ArayCHN/Smart_cart/(threads)

Thread 1 (2018-05-02):

Velocity calc by time interval error from time to time

ArayCHN, 2018-05-02:
一个奇怪的问题：在一些时候，当速度为0好久，然后启动一下，一瞬间速度会很小，紧接着接下来就会出现一个很大的速度。这个速度是错误的，但是为什么会得到这个结果？
目前的workaround: 再control loop获取速度以后，判断是否实际，太大的话就丢弃。

ArayCHN, 2018-05-16:
No better solution, arbitrarily get rid of these high values.

Closed 2018-05-16.

Thread 5 (2018-05-15):

velocity from two modes need to be checked!

ArayCHN, 2018-05-15:
The vel calculated by two diff methods need to be verified if they are close to each other!!! If there is a diff, then can it be solved by simple offset? To verify if we need to use one mode for all velocities or we are good with two modes.

Closed 2018-05-16.

Thread 6 (2018-05-15):

Task May 16th. class

ArayCHN, 2018-05-15:
issue #2 Meanfilter, #5 two velocity methods check
+ complete code for entire car, add zhukai's code

ArayCHN, 2018-05-16:
zhukai's code will be added later

Closed 2018-05-16.

Thread 8 (2018-05-23):

Ultrasonic: miss obstacle

ArayCHN, 2018-05-23:
ultrasonic detects an obj, avoids it. when avoiding, may lose track of the obj becuz of turning. Consider this! impose a time lag, for example before 2 secs ends the obstacle is not fully avoided, no matter whether the ultrasonic module tells you so.

ArayCHN, 2018-05-28:
another enhancement:
velocity calculation w/ both methods combined.

ArayCHN, 2018-05-28:
solved, not tested yet

Closed 2018-05-28.

Thread 10 (2018-05-30):

motor reverse rotate wrong

ArayCHN, 2018-05-30:
maybe cannot reverse rotate? check the wiring! maybe redo the wiring.

ArayCHN, 2018-05-30:
additional bug:!!! time_flag = 1, implement something, then set time_flag = 0!!!

Closed 2018-05-31.

Thread 12 (2018-06-03):

Parameter Tuning Notes!

ArayCHN, 2018-06-03:
linear velocity should not be too large. less than 800! because when vel too large in straight line, when there is an obstacle, it is too hard for the cart to stop and detour. This will significantly slow the cart down overall. Would be better off slow the cart in straight line and try to accelerate it at turning.

ArayCHN, 2018-06-09:
The final tuning tip: make PID ki == 0.
This greatly improves the tracking performance at turings.

Closed 2018-06-09.
