ArayCHN/Smart_cart/circuit.pdf

# MotorDriver_L1 MotorDriver_R1

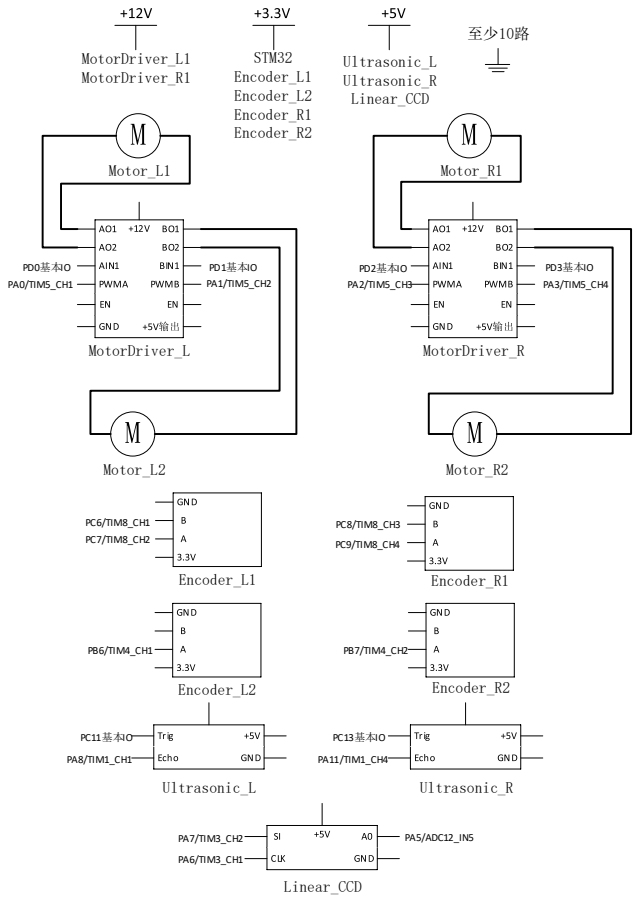
[picture p6: page 1]
Motor_L1; Motor_L2; Motor_R2; Motor_R1; MotorDriver_L; PD0基本IO; PA0/TIM5_CH1; PD1基本IO; PA1/TIM5_CH2; MotorDriver_R; PD2基本IO; PD3基本IO; PA2/TIM5_CH3; PA3/TIM5_CH4; Encoder_R1; PC8/TIM8_CH3; PC9/TIM8_CH4; Encoder_L1; PC6/TIM8_CH1; PC7/TIM8_CH2; Encoder_L2; PB6/TIM4_CH1; Encoder_R2; PB7/TIM4_CH2; Ultrasonic_L; PC11基本IO; PA8/TIM1_CH1; Ultrasonic_R; PC13基本IO; PA11/TIM1_CH4; Linear_CCD; PA7/TIM3_CH2; PA5/ADC12_IN5; PA6/TIM3_CH1; STM32 Encoder_L1 Encoder_L2 Encoder_R1 Encoder_R2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

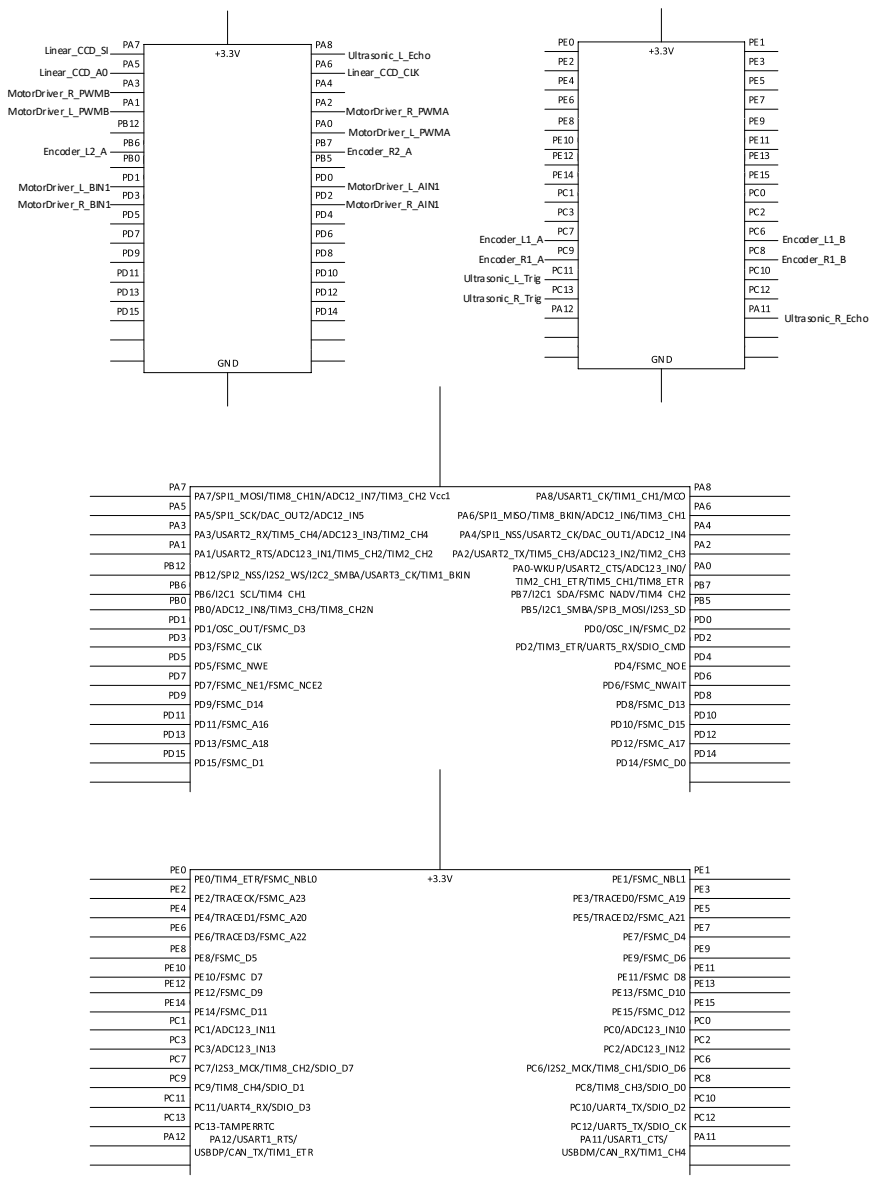
[picture p7: page 2]
Encoder_R1_A; Encoder_R1_B; Encoder_L1_A; Encoder_L1_B; Ultrasonic_L_Trig; Ultrasonic_R_Trig; Ultrasonic_R_Echo; MotorDriver_L_BIN1; MotorDriver_L_AIN1; MotorDriver_L_PWMA; MotorDriver_L_PWMB; MotorDriver_R_BIN1; MotorDriver_R_AIN1; MotorDriver_R_PWMA; MotorDriver_R_PWMB; Encoder_L2_A; Encoder_R2_A; Ultrasonic_L_Echo Linear_CCD_SI; Linear_CCD_A0; Linear_CCD_CLK
