ArayCHN/Smart_cart/USER/led.c

#include "led.h"
#include "stm32f10x.h"

void LED_Init(void)
{
	GPIO_InitTypeDef  GPIO_InitStructure;
	RCC_APB2PeriphClockCmd(RCC_APB2Periph_GPIOB, ENABLE);	 

	GPIO_InitStructure.GPIO_Pin = GPIO_Pin_13;				
	GPIO_InitStructure.GPIO_Mode = GPIO_Mode_Out_PP; 		 
	GPIO_InitStructure.GPIO_Speed = GPIO_Speed_50MHz;		
	GPIO_Init(GPIOB, &GPIO_InitStructure);
	GPIO_SetBits(GPIOB,GPIO_Pin_13);

	GPIO_InitStructure.GPIO_Pin = GPIO_Pin_14;	  
	GPIO_Init(GPIOB, &GPIO_InitStructure);
	GPIO_SetBits(GPIOB,GPIO_Pin_14);
}
