ArayCHN/Smart_cart/(commit log)

2018-04-17 parameterised PWM test
2018-04-17 1st version PWM for 4 motors
2018-04-21 added systick and encoder mode for velocity calculation
2018-04-21 modification before motor test
2018-04-25 tested encoder velocity
    tested encoder velocity
2018-04-30 finished and tested encoder mode and velocity calc
2018-05-02 added another velocity counter method
2018-05-02 tested motor and spotted problems for timing mode
    [main.c]
2018-05-02 corrected cart vel cal w/ time interval method
    [main.c]
2018-05-02 tested motor vel time interval method okay
2018-05-02 updated readme for time interval method of velocity measure
2018-05-03 reorganized project, seprated files, and added ultrasonic test
2018-05-03 temporary for ultrasonic
2018-05-09 tested ultrasonic right
2018-05-09 finished ultrasonic test and written documents for it
2018-05-09 corrected cart vel calc with time interval method
    [main.c, motor_vel_time_interval.c]
2018-05-09 pwm motor
2018-05-13 test motor pwm control
2018-05-13 tested motor pid
2018-05-13 updated readme for pwm pid control
2018-05-16 completed two velocity test and other tests
2018-05-30 tested all 4 motors right!
2018-05-30 integrated ultrasonic right
2018-06-30 some corrections for zk code
    [Bluetooth.c, Bluetooth.h, ccd.c, ccd.h, controller.c, controller.h, led.c]
